SmOeL-swdev/MHI-AC-Ctrl/images/HA-MHI-CTRL_Settings.png

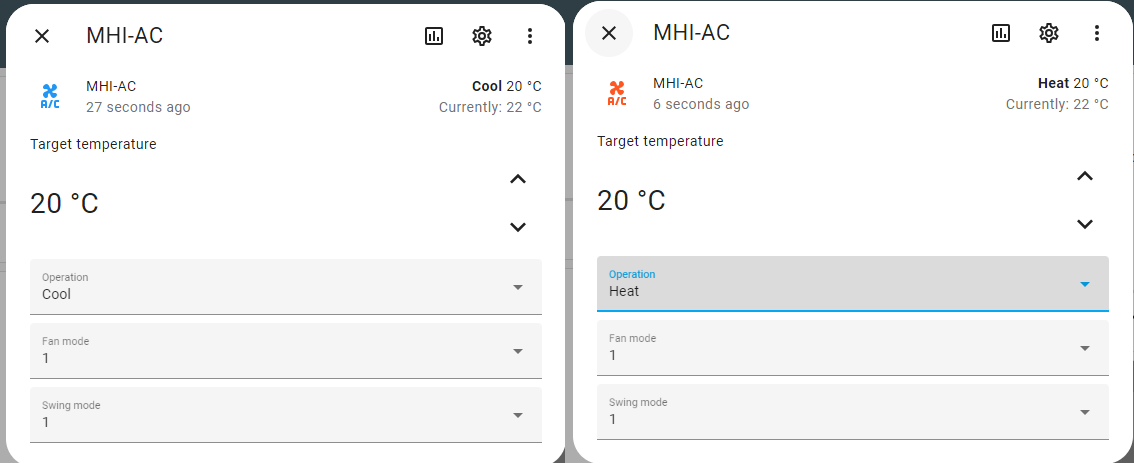
images/HA-MHI-CTRL_Settings.png
