SmOeL-swdev/MHI-AC-Ctrl/Altium/MHI_Board/LocalLib/B5B-XH-A_LF__SN_.stp

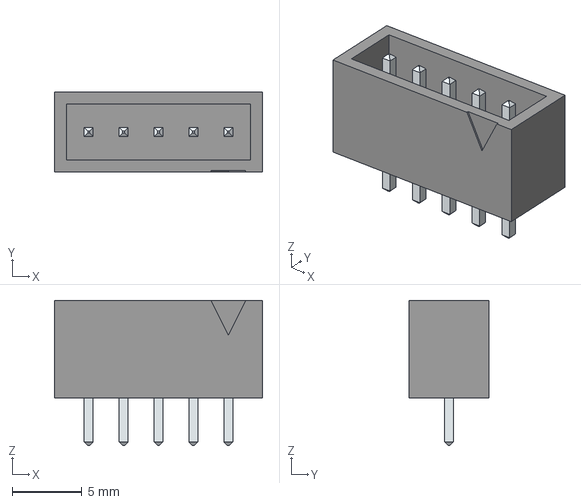
[picture p5: CAD file, 2026-05-22]
Altium/MHI_Board/LocalLib/B5B-XH-A_LF__SN_.stp
14.9 x 5.75 x 10.4 mm
LeadsArray
