SmOeL-swdev/MHI-AC-Ctrl/(threads)

Thread 3 (2023-08-04):

Internal Cross-talk ESP MISO pin GPIO12 (Wemos D6)

SmOeL-swdev, 2023-08-04:
**To Reproduce**
Name of my AC:  SRK50ZS-W
Used MHI-AC-Ctrl HW: Custom build PCB
Used MHI-AC-Ctrl SW: V2.8.1

**Describe the bug**
Connected serial uart to device, ESP reboots into softwdt loop. Bootloop caused in the measurefrequency() function to determine SPI clock speeds. fMISO and fMOSI have the same frequency of ~540kHz.
* Filtering at the pins (directly at ESP) causes the signal to filter too much such that signals are also influenced and no longer valid
* Added serial impedance in MISO and MOSI that also did not solve the issue.
* Additional filtering at LDO's and Vcc pins (100nF) did not solve the issue
* Adding pull-ups at the input of the level translator (different level translator than in schematic) did not solve the issue
* Adding pull ups at the output of the level translator did not solve the issue
*  Turning on internall pull-up at MISO did not solve the issue

Closed 2023-08-05.

Thread 6 (2023-08-05):

HA MHI active settings not refreshed regular

SmOeL-swdev, 2023-08-05:
When changing a setting for the AC the Home assistant might not get all current settings from the MHI-AC. This can be retrieved by resetting the airco (which should not be the way to get this done).

After changing one of the following settings, all states should be posted on MQTT to keep systems in sync:
Mode
Power
Fan
Vanes

Thread 13 (2023-12-22):

PowerState not shown in HA

SmOeL-swdev, 2023-12-22:
The current MHI status is not shown in HA due to:
**home assistant** climate power_state_topic deprecated as of 2023.9

Depending if this can be fixed at HA side this might require update on MHI-CTL side
