SmOeL-swdev/MHI-AC-Ctrl/(list of files, drawings)

Other design files:
Altium/MHI_Board/LocalLib/MHI_Board.PcbLib
Altium/MHI_Board/LocalLib/MHI_Board.SCHLIB
Altium/MHI_Board/LocalLib/Schlib1.SchLib
Altium/MHI_Board/MHI_Board.PrjPcb
Altium/MHI_Board/MHI_Board.SchDoc
