SmOeL-swdev/MHI-AC-Ctrl/(commit log)

2023-07-24 Further clean-up; removing ArduinoOTA stuff
2023-07-29 improving SPI communication by setting CPU freq to 160MHz, changed loop time to 60ms
2023-08-04 index on develop/minorimprov: 2cfcf75 improving SPI communication by setting CPU freq to 160MHz, changed loop time to 60ms
2023-08-04 Changed MISO pin to GPIO16, GPIO12 seems to have internall cross-talk
2023-08-06 Adding some information in and getting ready for some testing for issue #6
    [main.cpp]
2023-08-09 #6 Optimized function to prevent 'Repeat Yourself' by using a status boolean
    [MHI-AC-Ctrl-core.cpp, MHI-AC-Ctrl-core.h, main.cpp]
2024-06-22 adding Altium PCB board for MHI-CTRL to the repo
    [B5B-XH-A_LF__SN_.stp, MHI_Board.PcbLib, MHI_Board.PrjPcb, MHI_Board.SCHLIB, MHI_Board.SchDoc, Schlib1.SchLib]
2024-06-22 removing Kicad files
    [MHI-AC-CTRL-B_Cu.gbl, MHI-AC-CTRL-B_Mask.gbs, MHI-AC-CTRL-B_Paste.gbp, MHI-AC-CTRL-B_Silkscreen.gbo, MHI-AC-CTRL-Edge_Cuts.gm1, MHI-AC-CTRL-F_Cu.gtl, MHI-AC-CTRL-F_Mask.gts, MHI-AC-CTRL-F_Paste.gtp]
2024-06-22 Tenting GND plane via's, modified board outline cut-outs
2024-06-22 Finalizing design with latest modifications and DF-checks from JLC-PCB
    [MHI_Board.PrjPcb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]
2026-05-22 feat: add Vanes Left/Right and 3D auto control support
    Port extended frame (33-byte WF-RAC protocol) from upstream commit
    absalom-muc/MHI-AC-Ctrl@dcb6192. Adds:
    - VanesLR control (positions 1-7 + swing) via MQTT
    - 3D auto mode (on/off) via MQTT
    - Extended SPI frame support (33 bytes)
    - USE_EXTENDED_FRAME_SIZE compile flag (opt-in, disabled by default)
    MQTT topics: MHI-AC/set/VanesLR, MHI-AC/set/3Dauto
    No behavior change when USE_EXTENDED_FRAME_SIZE is not defined.
2026-05-22 Update HA config for include_dir_merge_list structure
    Split entities into separate files matching HA folder-per-type layout:
    - ha_config/airco/MHI_AC_General.yaml -> mqtt: climate:
    - ha_config/select/MHI_AC_VanesLR.yaml -> mqtt: select: (new)
    - ha_config/switch/MHI_AC_3Dauto.yaml -> mqtt: switch: (new)
    VanesLR/3Dauto require USE_EXTENDED_FRAME_SIZE enabled in firmware.
2026-05-23 Add Home Assistant MQTT Auto-Discovery
    Firmware now publishes retained discovery payloads on MQTT connect:
    - Climate entity with modes, fan, vertical vanes (UD), horizontal vanes (LR)
    - 3D Auto switch entity (grouped under same HA device)
    - Human-readable vanes labels (Up/Down/Center, Left/Right/Wide/Spot)
    - Jinja2 templates translate between HA labels and firmware values
    - Uses PubSubClient streaming API (beginPublish/serializeJson/endPublish)
    to bypass v2.7 buffer size limits for large payloads
    Feature gated behind #define USE_HA_DISCOVERY (enabled by default).
    When active, manual HA YAML configuration is no longer needed.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
    [support.cpp, support.h]
2026-05-23 Enable USE_EXTENDED_FRAME_SIZE by default
    Enables 33-byte SPI frame for VanesLR and 3D Auto support out of the box.
2026-05-24 Fix availability: publish connected status as retained
    The LWT publishes '0' with retain=true on disconnect, but the 'online'
    message was published without retain. HA never sees a retained '1' so
    the discovered entity stays 'unavailable'.
    Fix: publish 'MHI-AC/connected' = '1' with retain=true after connect.
    Also mark manual HA config files as reference-only (not needed when
    USE_HA_DISCOVERY is enabled).
    [support.cpp]
2026-05-24 docs: add ECO/Silent mode research findings
    - Created docs/ECO_Silent_Research.md with detailed protocol analysis
    - Updated Troubleshooting.md known limitations (VanesLR/3D now supported)
    - Linked ECO/Silent entry to research document
    - Documents opcode DB9=0x21 clue from upstream issue #219
    - Notes path to implementation (SPI trace required)
